chen111111111112121/bs_znjj/SCH_Schematic1_2026-10-24.pdf

+3.3V 20 VBAT 21 PC13 22 PC14 23 PC15 24 PA0 25 PA1 26 PA2 27 PA3 28 PA4 29 PA5 30 PA6 31 PA7 32 PB0 33 PB1 34 PB10 35 PB11 36 RESET 37 +3.3V 38 GND 39 GND 40

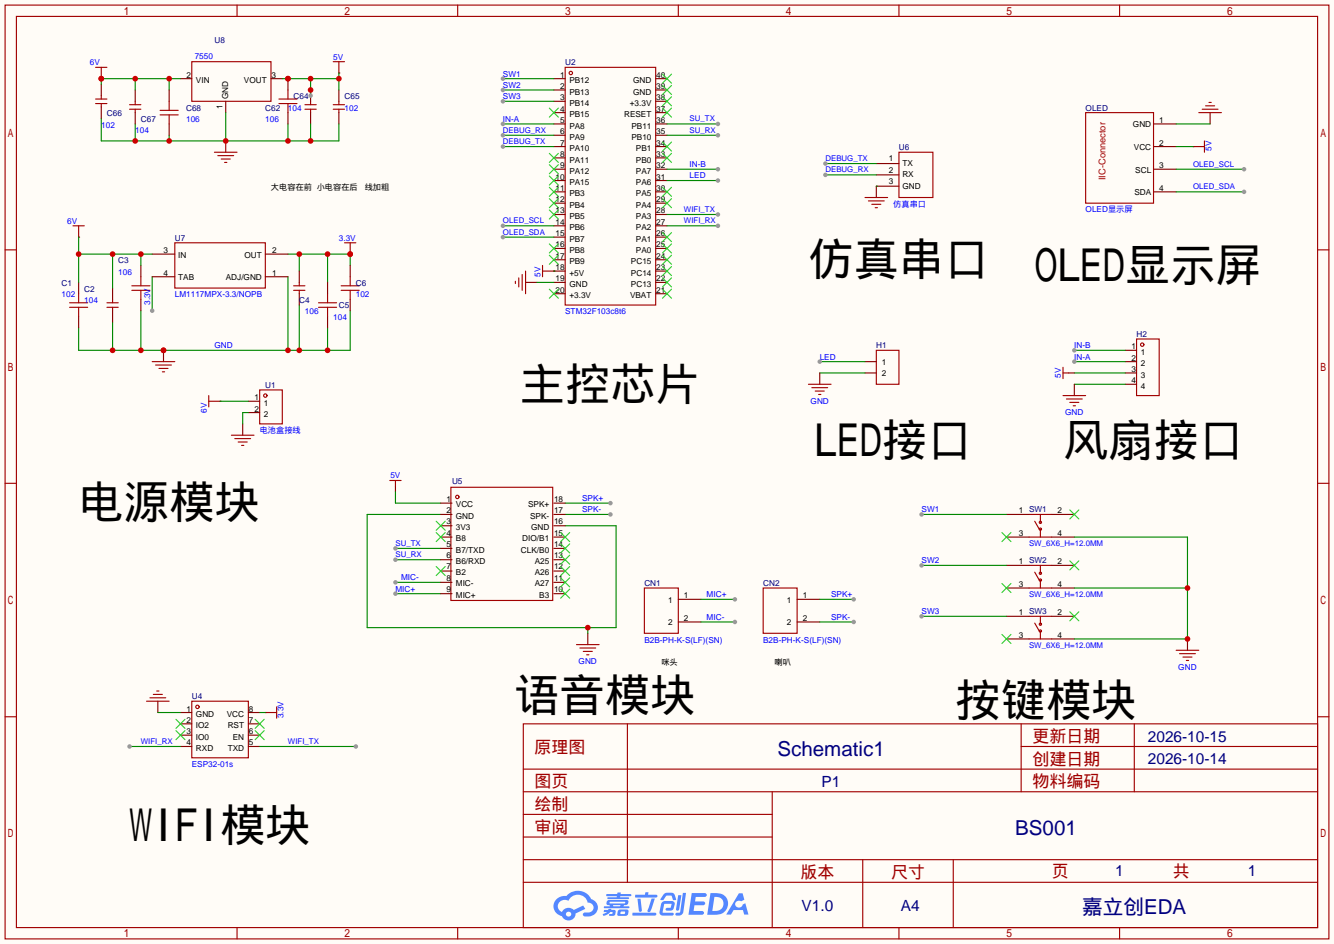
[picture p1: page 1]

SPK+
B3 10 A27 11 A26 12 A25 13 CLK/B0 14 DIO/B1 15 GND 16 SPK- 17 SPK+ 18
