chen111111111112121/bs_znjj/firmware/SmartHomeDemo/Core/Src/main.c

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
/* Includes ------------------------------------------------------------------*/
#include "main.h"
#include "i2c.h"
#include "tim.h"
#include "usart.h"
#include "gpio.h"


/* USER CODE BEGIN PV */
/* Watch these counters in Keil during the first board bring-up. */
volatile uint32_t g_r01_heartbeat = 0;
volatile uint32_t g_r01_uart_errors = 0;
static uint32_t r01_last_heartbeat_ms;
/* USER CODE END PV */

void SystemClock_Config(void);
/* USER CODE BEGIN 0 */
static void R01_Log(const char *text, uint16_t length)
{
  if (HAL_UART_Transmit(&huart1, (const uint8_t *)text, length, 100U) != HAL_OK)
  {
    ++g_r01_uart_errors;
  }
}
/* USER CODE END 0 */

/**
  * @brief  The application entry point.
  * @retval int
  */
int main(void)
{

  /* MCU Configuration--------------------------------------------------------*/

  /* Reset of all peripherals, Initializes the Flash interface and the Systick. */
  HAL_Init();

  /* Configure the system clock */
  SystemClock_Config();

  /* Initialize all configured peripherals */
  MX_GPIO_Init();
  MX_I2C1_Init();
  MX_USART1_UART_Init();
  MX_USART2_UART_Init();
  MX_USART3_UART_Init();
  MX_TIM1_Init();
  MX_TIM2_Init();
  MX_TIM3_Init();
  /* USER CODE BEGIN 2 */
  static const char boot_message[] =
    "\r\n[R01] SmartHomeDemo boot\r\n"
    "[R01] HSE=8MHz SYSCLK=72MHz APB1=36MHz APB2=72MHz\r\n"
    "[R01] USART1=115200 8N1; TIM2=1MHz; PWM outputs not started\r\n";

  if ((HAL_RCC_GetSysClockFreq() != 72000000U) ||
      (HAL_RCC_GetHCLKFreq() != 72000000U) ||
      (HAL_RCC_GetPCLK1Freq() != 36000000U) ||
      (HAL_RCC_GetPCLK2Freq() != 72000000U))
  {
    Error_Handler();
  }
  if (HAL_TIM_Base_Start(&htim2) != HAL_OK)
  {
    Error_Handler();
  }
  /* PWM channels stay stopped until their hardware modules are implemented. */
  R01_Log(boot_message, (uint16_t)(sizeof(boot_message) - 1U));
  r01_last_heartbeat_ms = HAL_GetTick();
  /* USER CODE END 2 */

  /* Infinite loop */
  /* USER CODE BEGIN WHILE */
  while (1)
  {
    /* USER CODE END WHILE */

    /* USER CODE BEGIN 3 */
    uint32_t now_ms = HAL_GetTick();
    if ((uint32_t)(now_ms - r01_last_heartbeat_ms) >= 1000U)
    {
      static const char heartbeat_message[] = "[R01] alive\r\n";
      r01_last_heartbeat_ms = now_ms;
      ++g_r01_heartbeat;
      R01_Log(heartbeat_message, (uint16_t)(sizeof(heartbeat_message) - 1U));
    }
  }
  /* USER CODE END 3 */
}

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
