chen111111111112121/bs_znjj/firmware/SmartHomeDemo/Core/Inc/main.h

#define FAN_IN_B_Pin GPIO_PIN_7
#define FAN_IN_B_GPIO_Port GPIOA
#define DHT11_DATA_Pin GPIO_PIN_0
#define DHT11_DATA_GPIO_Port GPIOB
#define KEY_LED_Pin GPIO_PIN_12
#define KEY_LED_GPIO_Port GPIOB
#define KEY_FAN_Pin GPIO_PIN_13
#define KEY_FAN_GPIO_Port GPIOB
#define KEY_SPEED_Pin GPIO_PIN_14
#define KEY_SPEED_GPIO_Port GPIOB
