chen111111111112121/bs_znjj/(notices)

Notices in the files:
firmware/SmartHomeDemo/Core/Inc/main.h:
Copyright (c) 2026 STMicroelectronics.
All rights reserved.
This software is licensed under terms that can be found in the LICENSE file
